horga83/dc-load/dc_load_schematic.pdf

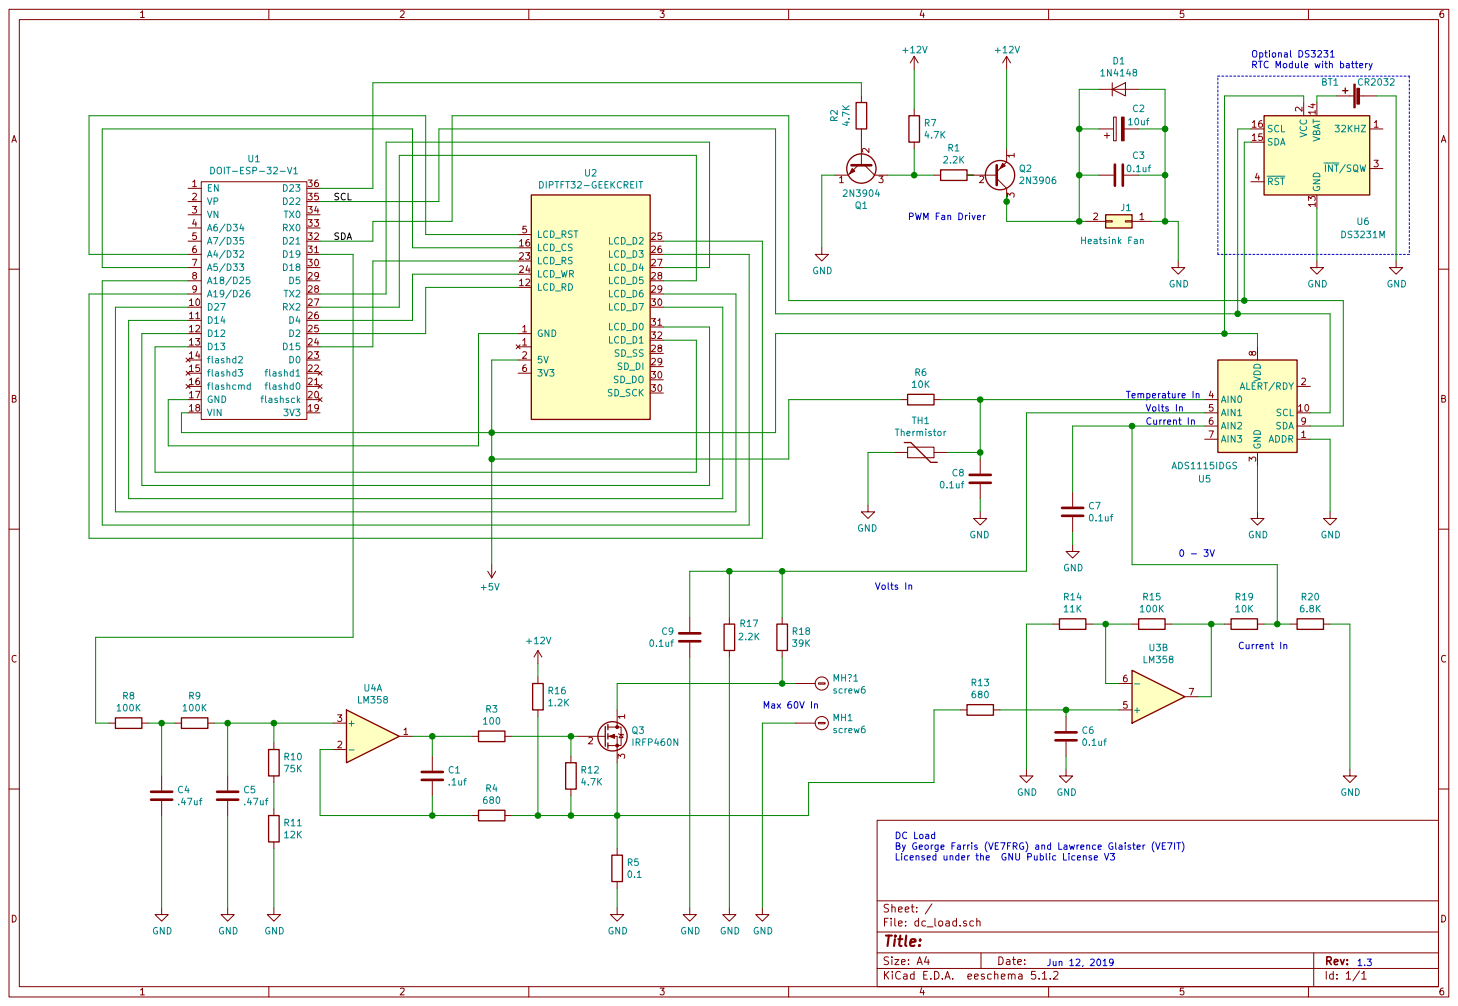
[picture p1: page 1]

Optional DS3231
RTC Module with battery GND

0 - 3V DC Load By George Farris (VE7FRG) and Lawrence Glaister (VE7IT) Licensed under the GNU Public License V3
