horga83/dc-load/(commit log)

2019-06-03 Fix fan routine
    Map doesn't work on over value
    [interface-esp32.ino]
2019-06-11 Change thermistor voltage
    Thermistor was originally 3.3V, but was changed to 5V
2019-06-12 Change current sensor values
    Change opamp resistors and voltage divider resistors
2019-06-12 Mostly current sensor formula
    Delete some print statements, modify formulas for current sensor and pwm for setting current.
2019-06-13 Added DS3231 I2C real time module
    Added optional code for DS3231 I2C battery backed real time clock. After a preset time on splash screen without any touch input, the clock will display.
2019-06-13 Added RTC module
    Added DS3231 RTC module with battery backup
2019-07-02 Add anti oscillate code to fan
    Added code to stop the fan from coming on and off every 30 seconds or so when the temperature hangs around the FAN_START_TEMP.
    [interface-esp32.ino]
2020-01-05 Added option to set the Real Time Clock Go to set screen, set the clock and press reset.
    [interface-esp32.ino]
